masonac3/edf-testbed/LOG.md

# Engineering Log

Append only. Never edit a past entry - if it was wrong, write a new entry
saying so. One entry per working session, including sessions where nothing
worked, because those are the ones worth having later when a result looks
strange.

---

## TEMPLATE - copy this block

```
## YYYY-MM-DD

Config: <ID from CONFIGS.md>
Ambient: <T degC, P hPa, RH %>

Intent:
- what I set out to do

Did:
- what actually happened
- raw files written: data/raw/...

Observed:
- numbers, anomalies, things that looked wrong

Notes / next:
- open questions, what to try next time
```

---

## 2026-09-09

Config: n/a
Ambient: n/a

Intent:
- Set up repo

Did:
- Repo initialised.

Observed:
- n/a

Notes / next:
- Tomorrow I would like to order all my parts and then do some CAD for what my test stand will look like.
- I will use the budgeting document and fill in/correct any prices that may differ from the sheet to real life. I think what is more important than manually correcting the prices is to just have what I actually spent written down. Goodnight 09/09 Mason

## 2026-09-10

Config: n/a
Ambient: n/a

Intent:
- Today I want to purchase wave 1, make sure everything is ready to go and hopefully start CAD if possible.

Did:
- Was sick this morning so lost some work time, main things accomplished today were wave 1 purchases. I also made some changes as the EDF trainer plane I bought needed some different specs and some items I wanted were out of stock. CAD didn't start, talked to Jayden looked into some competitions like DARPA Lift challenge may look into this more on the side however this project will take priority. Something that drew me to DARPA was that unlike this project that has design constraints choosen by myself, competitions are designed with specific goals rather than just to gain more experience. I think that it would be cool to take part and see how far I can get. Below will be some purchases that deviated from the original plan:
- Recievers (RadioMaster ER8 ELRS PWM) 2 -> 1 as it was more than I expected and it won't be needed till march during phase 5 anyways when I begin the actual airframe
- LiPo battery changed from 4000 mAh/XT60 to 3300 mAh/EC5. 4000mAh was out of stock, 3300 will be enough and was the best option in the moment to recieve all parts on time and begin test flights for phase 0. EC5 was the only option here too so EC5 - XT60 convertors were bought too. 
- LiPo battery 3 -> 2, Amazon sold in pairs, not too big of a deal honestly. If I need another I'll just buy it later on, also charger only does 2 at a time anyways so it'll be fine. 

Observed:
- n/a asides from big bucks spent ($974.15)

Notes / next:
- Tomorrow when I'm free I would like to begin the CAD and watch videos to be better informed for the phases coming up. For CAD specifically start the Thrust stand hopefully finish by Saturday if possible as thats when alot of parts come. This will also include how I want the thurst stand to be designed, quick drawing on ipad first then create the cad.

## 2026-09-14

Config: n/a
Ambient: n/a

Intent: 
- Mark down on purchase tracker what arrived in the mail. Some things are still not here, and I'm a little unsure how to proceed (wait till trainer gets here or start something now). For now, I will just mark down on the tracker and ask claude for something to do.

Did:
- Marked down items that were received yesterday and today. Spoke to claude about things to do, want to work on some CAD or study components but dont have much time today.
- 

Observed:
- n/a

Notes / next:
- Today was a small day, I would like to watch more informational videos to get a better understanding of this project. I also want to work on the CAD like I spoke about earlier, as I didn't have much time today.

## 2026-09-24

Config: n/a
Ambient: n/a

Intent:
- Watch PF-1 from LearnNX to study necessary tools for making CAD with variations. Begin test stand CAD. Some more packages arrived so look at everything that has come and verify with purchase tracker.

Did:
- Finished watching the video and organized CAD folder. Created first cad part file for baseplate of test stand. 

Observed:
- YAK130 arrived as well as the Radiomaster controller, but can't find in package room so will call tomorrow morning to find.

Notes / next:
- Get packages. complete more cad.

## 2026-10-03

Config: n/a
Ambient: n/a

Intent:
- IM BACK. Today I will work on test stand cad, some packages also arrived finally so I need to mark it down in the purchase tracker. Also YAK-130, rc controller, reciever, and some batteries came so I'll charge the batteries later and try to test fly tomorrow. 

Did:
- Found Datasheet for TAL220, completed CAD for basestand, however need to do some measurements and planning for the rest of the stand.

Observed:
- numbers, anomalies, things that looked wrong

Notes / next:
- continue working on CAD
