masonac3/edf-testbed/admin/EDF_Project_Phase_Plan.docx

# Chin-Inlet EDF UAV Testbed — Phase Execution Plan

Project objective: Quantify the installed thrust penalty of a chin-mounted S-duct inlet on a 70 mm EDF, reduce it through design iteration, and validate a CFD model against self-generated test data on a flying airframe.

Primary figures of merit: Duct loss coefficient, installed thrust ratio, and DC60 distortion, tied to predicted and measured maximum level airspeed.

Revision A — corrected metric scale. The first version of this plan set inlet pressure recovery thresholds at 0.95 / 0.98, borrowed from turbine engine practice. Those are wrong by more than an order of magnitude for an EDF. See "Why the metrics are scaled this way" below.

## Cross-cutting rules

These apply to every phase. Violating them is how projects lose their data.

Configuration control. Every physical article that goes on the stand gets an ID and a card: N-085-A = nozzle, 85% FSA, first print. Record the ID on every data run. Two identical-looking printed nozzles are not identical, and six months later you will not remember which was which.

Measure what you built, not what you drew. Printed dimensions deviate from CAD by up to a few tenths of a millimeter. Caliper every exit diameter, every throat, and report the measured value. Area scales as diameter squared, so a 0.3 mm error on a 25 mm exit is a 2.4% area error — bigger than the effects you're chasing.

Record ambient conditions every session. Temperature, pressure, humidity. Air density varies ~10% between a cold morning and a hot afternoon, and thrust scales directly with it. Correct all thrust data to standard density (1.225 kg/m³) before comparing across days:

T_corrected = T_measured × (1.225 / ρ_measured)

Uncorrected data taken on different days is not comparable, and this is the single most common way amateur thrust testing produces garbage.

Log entry per session, same day. Date, config IDs, ambient conditions, what you intended, what happened, what broke, raw file names. Append-only.

Test report per phase, within one week. Objective / hardware / procedure / raw data / uncertainty / results / conclusions. The final paper is an assembly of these, not new writing.

## Phase 1 — Thrust stand and uninstalled baseline

Objective: Build a measurement system you trust, and characterize the bare fan with no ducting. Everything downstream is measured relative to this baseline, so if Phase 1 is sloppy the whole project is.

### Hardware

Item | Notes
Load cell, 5 kg | 10 kg if you plan to move to 12S later. Straight beam type.
HX711 breakout | 24-bit ADC, cheap, adequate. Runs at 10 or 80 SPS — use 80.
Arduino Nano or ESP32 | ESP32 if you want wireless logging
Inline watt meter, or INA226 + divider | INA226 logs; a hobby watt meter you read by eye does not
Optical tachometer | Or ESC telemetry if your ESC supports it
Calibration masses | 100 g / 200 g / 500 g / 1 kg, known to ±1%
Thermometer, barometer, hygrometer | Phone barometers are adequate; note the source
Bench PSU (preferred) or fresh 6S pack | See voltage sag note below

### Stand design

Direct axial mount — load cell in line with the thrust axis — is simpler than a pivot arm and avoids lever-ratio error. Mount the fan so the exhaust is clear for at least 5 fan diameters and the inlet is at least 3 diameters from any wall or the floor. Recirculation is invisible and will quietly inflate or deflate your numbers.

The stand must be stiff. A structure that resonates at fan frequency turns your load cell into an accelerometer. If your readings show large oscillation that grows with rpm, that's structural, not aerodynamic.

### Calibration procedure

1. Warm up the electronics 10 minutes before zeroing. Load cells drift thermally.
2. Hang known masses in ascending order, record raw ADC counts at each.
3. Hang them again in descending order. The difference between ascending and descending readings at the same load is hysteresis — record it, it goes in your uncertainty budget.
4. Fit a linear calibration. Report R² and the maximum deviation from linearity.
5. Re-zero and check drift over 10 minutes with no load.

### Test procedure

Throttle sweep, 30% to 100% in 10% steps, 5 seconds stabilized at each point, then descending back down. Record thrust, current, voltage, rpm at each point.

Voltage sag will corrupt this if you let it. A 6S pack drops meaningfully under a 60 A load, so a descending sweep runs at lower voltage than the ascending one and you'll see apparent hysteresis that's really just battery state of charge. Either use a bench supply, or record voltage at every point and plot thrust against actual electrical power rather than throttle percentage.

### Uncertainty budget

Build the table now; you'll reuse it all project. Contributors: load cell nonlinearity, hysteresis, zero drift, ADC quantization, calibration mass tolerance, air density measurement, rpm measurement, voltage/current sensor accuracy. Combine in quadrature for the total. Report every result as value ± uncertainty.

This is the part almost no undergraduate does, and it's the part that makes the rest credible.

### Exit gate

Three complete sweeps on three separate days agree within ±2% at every throttle point after density correction, with a documented uncertainty budget.

### Deliverable

Test Report 01 — calibration curve, thrust / power / rpm vs. throttle, uncertainty budget, repeatability data.

### Common failure modes

Stand resonance corrupting readings · thermal drift from skipping warmup · recirculation from testing too close to a wall · ESC or motor heat soak changing performance partway through a sweep (let it cool between runs).

## Phase 2 — Nozzle exit area trade study

Objective: Quantify the mass flow vs. exhaust velocity tradeoff and pick the exit area that maximizes predicted top speed, not static thrust.

### Preparation

Compute FSA from measured hardware, not the spec sheet:

FSA = (π/4) × (D_fan² − D_hub²)

Print four nozzles at 90%, 85%, 80%, 78% of FSA. Hold everything else constant — same bellmouth inlet, same thrust tube length, same contraction length, same material, same layer height, same interior finish. One variable at a time.

Contraction should be gradual. A sharp area change separates and you'll be measuring your bad geometry rather than the area ratio.

Caliper each exit and record the actual area.

### Test procedure

Identical to Phase 1. Three runs per nozzle, ideally interleaved across days rather than all four nozzles on one day — that way a day-to-day bias doesn't map onto the variable you're studying.

### Analysis

For each nozzle compute:

- Static thrust, density corrected, with error bars
- Thrust per watt
- rpm vs. area ratio (rpm should rise as area shrinks — the fan is unloading aerodynamically; if it doesn't, something is wrong)
- Estimated exhaust velocity: from T = ρ·A_exit·Ve², so Ve = √(T / (ρ·A_exit))
- Predicted Vmax for each, by solving the thrust-drag intersection with an estimated airframe drag area:

ṁ(Ve − V) = ½ρV²·CD0·S

The last one is the point. Expect static thrust to fall as you tighten the nozzle while predicted Vmax rises. That inversion is the whole result, and it's the plot that goes in the paper.

### Exit gate

Four nozzles ranked with error bars, and a selection justified on predicted Vmax with the static thrust penalty stated explicitly.

### Deliverable

Test Report 02 — nozzle trade study.

## Phase 3 — Inlet characterization (core phase)

Objective: Measure total pressure recovery and DC60 distortion for three inlet configurations. This is the phase that produces the resume line.

### Configurations

ID | Description | Role
I-STR | Straight duct, bellmouth inlet | Control — best achievable
I-SD1 | Chin S-duct, baseline | The design under test
I-SD2 | Chin S-duct + boundary layer diverter + flow conditioning | The improvement

I-SD2 conditioning options worth trying: a splitter plate standing the lip off the fuselage by 1.5–2× local boundary layer thickness, vortex generators upstream of the second bend, and increased bend radius if packaging allows.

### The rake

Eight total pressure probes on a single radial arm, indexed circumferentially in 45° increments to map the full fan face. This is far cheaper than 40 fixed probes and removes probe-to-probe bias, at the cost of taking eight times as long.

Place probes at equal-area centroids, not equal radial spacing. For an annular face, divide the annulus into 8 equal-area rings and put a probe at each ring's area centroid. Equal spacing over-weights the hub and will systematically bias your average.

Probes: hypodermic tubing, square-cut, facing directly into the flow. Total pressure probes are forgiving to about ±10° of misalignment and under-read badly past that, so alignment matters more than probe quality.

Keep total rake blockage under 5% of the fan face area. Above that you're measuring a flow field you created.

Sensor selection — this is where the first version of this plan was wrong. An MPXV7002DP is ±2 kPa full scale with roughly 2.5% FS accuracy, which is ±50 Pa of error. The pressure differences you are trying to resolve are 150–400 Pa. That's 12–30% error on your primary measurement, which would swamp the effect.

Use a low-range digital sensor instead. Sensirion SDP31 or SDP810 (±500 Pa, roughly 0.2% of reading, sub-Pascal resolution over I²C) puts your sensor error two orders of magnitude below your signal. Roughly $40–60 each, which is why multiplexing matters: solenoid-multiplex all eight tubes into one good sensor rather than buying eight mediocre ones. That also eliminates sensor-to-sensor calibration bias entirely.

Mount the rake at least 0.5 fan diameters upstream of the blades. Closer and you're in the blade potential field.

### Calculations

Pressure recovery: PR = P̄t2 / Pt0, where P̄t2 is the area-weighted average of your probe readings and Pt0 is ambient total pressure for static testing.

DC60: DC60 = (P̄t2 − P̄t2,worst60) / q2

where P̄t2,worst60 is the lowest average over any contiguous 60° sector, and q2 is dynamic pressure at the fan face. Write your exact definition into the report — DC60 has variants and reviewers will ask which you used.

### The honest limitation

Static ground testing does not reproduce flight inlet conditions. At zero forward speed the inlet runs at very high mass flow ratio, the lip loads up differently, and you get no forebody boundary layer to divert — which is the entire problem the diverter exists to solve. Your static numbers will look better than reality.

Say this plainly in the report. Better: get a session in the UIUC subsonic tunnel and repeat at 20–30 m/s. Even one tunnel run alongside your static data transforms the credibility of this phase, and a reviewer who sees the limitation acknowledged trusts the rest of your work more, not less.

### Exit gate

Three configurations characterized with differences that exceed measurement uncertainty. Target: reduce duct loss coefficient K by ≥0.15 from I-SD1 to I-SD2, equivalently recovering ≥5% of fan pressure rise, or a documented explanation of why not.

### Why the metrics are scaled this way

Work the fan's pressure rise backwards from exhaust velocity:

Δp_fan ≈ ½ρVe² = ½(1.225)(65²) ≈ 2,600 Pa

Against 101,325 Pa ambient, that is a pressure ratio of about 1.026. A turbofan runs 30–40. Everything about ducting an EDF follows from that number.

Duct losses scale with dynamic pressure inside the duct: Δp_loss = K · q_duct. At 45 m/s duct velocity, q_duct ≈ 1,240 Pa, so a single bend at K = 0.3 costs ~370 Pa — 14% of everything the fan produces.

This is why turbine-engine recovery figures are the wrong instrument. A PR of 0.95 means losing 5,000 Pa, roughly double the fan's entire output; the airplane would not move. Real EDF ducts need PR above 0.995, where all the information lives in the third decimal place and the metric becomes useless for tracking progress.

Use these instead:

Metric | Definition | Threshold | Objective
Duct loss coefficient | K = Δp_loss / q_duct | ≤ 0.35 | ≤ 0.15
Fraction of fan rise lost | Δp_loss / Δp_fan | ≤ 15% | ≤ 7%
Installed thrust ratio | T_installed / T_bare | ≥ 88% | ≥ 93%
Pressure recovery (reference only) | PR = P̄t2 / Pt0 | ≥ 0.995 | ≥ 0.998

Installed thrust ratio is the one to lead with in conversation — it is the easiest to measure, the hardest to argue with, and the easiest to explain in an interview. DC60 is unchanged; distortion is genuinely dimensionless and the standard definition transfers fine.

### Deliverable

Test Report 03 — inlet characterization. The core artifact.

### Common failure modes

Probe misalignment · tubing lag (long thin tubes low-pass filter your signal; keep runs short and equal length) · rake blockage · leaks at tube fittings (leak-check every line before every session).

## Phase 4 — CFD correlation

Objective: Predict PR and DC60 in Fluent, compare against Phase 3 measurements, and honestly characterize the disagreement.

### Setup

Do not model the rotating fan. Terminate the domain at the fan face and apply a mass flow outlet set to your measured ṁ. Sliding mesh or MRF for the rotor is a semester-long project by itself and adds nothing to an inlet study.

Domain: large hemispherical plenum upstream (at least 10 duct diameters) so the inlet draws from quiescent air, then the duct geometry as printed.

Mesh: prism layers on all duct walls. Either resolve the boundary layer with y+ < 1, or use wall functions with y+ between 30 and 300 — pick one and stay inside it. Report the y+ distribution, not just the target.

Turbulence model: SST k-ω. It handles adverse pressure gradients and separation in the S-bend better than k-ε, and separation is exactly what you're trying to capture.

### Grid independence study

Three mesh levels, roughly doubling cell count each time. Plot PR against cell count and show it converging. This is mandatory for credibility and routinely skipped — including it puts you ahead of most student CFD work immediately.

### Correlation

Compare predicted vs. measured PR and DC60. Report the discrepancy as a percentage and hypothesize causes: unmodeled surface roughness from layer lines, as-printed geometry deviation from CAD, rake blockage absent from the model, oversimplified fan face boundary condition.

A report that says "predicted 0.971, measured 0.958, a 1.3% discrepancy attributed primarily to unmodeled print surface roughness" is worth far more than one claiming perfect agreement. Nobody believes perfect agreement.

### Exit gate

Grid-independent solution for all three configurations, correlation within ±8% (threshold) or ±4% (objective) on PR, with discrepancies attributed.

### Deliverable

CFD Validation Report.

## Phase 5 — Airframe integration and flight test

Objective: Fly the airframe with the winning duct and nozzle, measure actual Vmax, and compare against the thrust-drag prediction from Phases 2 and 3.

### Design targets

- Static margin 8–12% MAC for first flight. Conservative on purpose; you can move CG aft later once it's flying.
- Horizontal tail volume coefficient Vh ≈ 0.5
- Vertical tail volume coefficient Vv ≈ 0.04
- Printed shell (LW-PLA), carbon tube spar carrying bending, PETG or ASA anywhere near the motor
- Plywood or CF hardpoint at the nose gear mount
- Nose gear aft of the inlet lip, or a mudguard on the strut

### Instrumentation

Pitot-static airspeed, current, voltage, rpm (ESC telemetry), 6-axis IMU, GPS, barometric altitude. IMU at ≥50 Hz, everything else at 10 Hz.

Calibrate the pitot before you trust it. Simplest method: tape it to a car roof on a still day and drive at known speeds. Uncalibrated pitot data is the most common reason flight test numbers don't match predictions.

### Pre-flight ground tests

Range check · control surface throw and direction verification · CG measurement against the design value · installed static thrust on the stand (compare to Phase 3 prediction) · taxi tests at increasing speed.

### Flight test cards

One objective per card, defined conditions, specific data product. Fly them in this order — this is envelope expansion, not a checklist to rush.

Card | Objective | Conditions | Data
FT-1 | Trim and handling | 50–60% throttle, altitude | Subjective; does it fly hands-off
FT-2 | Level speed runs | 50/60/70/80/90/100%, ≥5 s stabilized, reciprocal headings | Airspeed, current, voltage, rpm
FT-3 | Timed acceleration | Full throttle from marked speed | Airspeed vs. time
FT-4 | Sawtooth climbs | Fixed throttle, fixed airspeed, timed altitude gain | Climb rate for Ps calculation
FT-5 | Stall approach | At altitude, decelerating | Vstall for speed range ratio

Fly reciprocal headings on every speed run and average them. Wind otherwise biases your ground speed by the full wind velocity, and a 10 mph wind on a 130 mph airplane is an 8% error in one direction.

### Exit gate

Measured Vmax within 15% of the thrust-drag intersection predicted in Phase 2, or a documented explanation of the gap (usually drag area estimated too optimistically).

### Deliverable

Flight Test Report, including the predicted vs. measured thrust and drag curve overlay. That single plot closes the loop from analysis through ground test to flight test, and it's the figure that carries the paper.

## Phase 6 — Tail configuration study

Objective: Quantify the lateral-directional stability cost of canted twin verticals versus a single centerline fin.

### Configurations

Single centerline fin of area S_v, versus twin fins canted at angle θ, sized so 2 × S_twin × cos(θ) = S_v. That sizing is the point — it tests whether the cosine loss is the whole story or whether interference effects make it worse.

Make both tails swappable on the same airframe. Same CG, same weight (ballast to match), same test day.

### Procedure

At trim speed and altitude, input a sharp rudder doublet, then release to neutral and let the Dutch roll mode decay. Log yaw rate and roll rate through the IMU.

Extract from the yaw rate trace:

- Frequency from peak-to-peak spacing
- Damping ratio by the logarithmic decrement method on successive peak amplitudes

Repeat at least five times per configuration. Dutch roll extraction from a single noisy trace is unreliable; the repeats are what give you error bars.

### Exit gate

Frequency and damping ratio reported for both configurations with uncertainty, plus discussion of roll-yaw coupling differences.

### Deliverable

Test Report 04 — tail configuration study. This one is a clean A/B with measured stability derivatives, which is unusual in student work and reads very well.

## Schedule

Period | Phases
Fall 2026 | Phase 0 (proficiency), Phase 1, Phase 2
Winter break | Phase 3 rake fabrication, airframe CAD
Spring 2027 | Phase 3, Phase 4, Phase 5
Summer / Fall 2027 | Phase 6, paper writeup, AIAA Region III submission

AIAA Region III Student Conference papers are typically due in late winter for a spring conference — check the current deadline early, because it may force Phase 5 earlier than this schedule shows.

## Procurement

All hardware selection, pricing, and purchase sequencing live in the companion document, EDF_Project_Purchasing.md. The baseline build is a Schübeler DS-30-AXI HDS 70 mm fan with a 6S propulsion system and a deferred 12S upgrade path.

## Top risks

Risk | Mitigation
Airframe destroyed early, halting flight test | Phase 0 proficiency gate; print a second fuselage during Phase 3
Measurement uncertainty exceeds the effect size | Phase 1 gate exists precisely to catch this before it wastes Phase 3
Static-only inlet data lacks credibility | Pursue tunnel access early; acknowledge the limitation regardless
Schedule slips past the conference deadline | Reports are written per phase, so a partial paper is still submittable
Fluent license or access falls through | SU2 and OpenFOAM are free alternatives; identify a backup before Phase 4
Instrument resolution too coarse for the effect | Group A sensor selection addresses this; verify against a known reference before Phase 3
