masonac3/edf-testbed/admin/EDF_Project_Purchasing.docx

# Chin-Inlet EDF UAV Testbed — Purchasing and Cost Plan

Baseline configuration: Schübeler DS-30-AXI HDS 70 mm fan, 6S propulsion, deferred 12S upgrade path.

Prices are US street estimates and drift. Verify before ordering.

## Summary

| Estimate
Core build (Groups A–E) | $2,656
Contingency at 15% | $400
Core total | $3,056
Optional 12S upgrade (Group F) | $550
With 12S upgrade | $3,606

Deduct if already owned: transmitter $220, balance charger $90, bench power supply $120.

## Group A — Test stand and instrumentation

Needed for Phases 1–3.

Item | Spec | Qty | Unit | Total
Load cell | 10 kg straight beam | 1 | $12 | $12
HX711 ADC breakout | 24-bit, run at 80 SPS | 1 | $6 | $6
Arduino Nano | Stand + airborne spare | 2 | $12 | $24
Sensirion SDP810-500Pa | ±500 Pa differential, I²C | 1 | $55 | $55
Pneumatic solenoids | 3-way, 12 V, for rake multiplexing | 8 | $9 | $72
MOSFET driver board | ULN2803 or logic-level discretes | 1 | $12 | $12
Silicone tubing | 2 mm ID, 5 m, cut to equal lengths | 1 | $10 | $10
Hypodermic tubing | 19 ga, 1 m, rake probes | 1 | $15 | $15
INA226 sensor | Current + voltage logging | 2 | $9 | $18
Optical tachometer | Omit if ESC provides RPM telemetry | 1 | $22 | $22
Calibration mass set | 100 g / 200 g / 500 g / 1 kg, ±1% | 1 | $30 | $30
Barometer + thermo-hygrometer | For density correction | 1 | $22 | $22
Bench power supply | 24 V, 30 A minimum | 1 | $120 | $120
| | | Subtotal | $418

Use one SDP810 multiplexed across all eight rake tubes rather than eight separate sensors — cheaper and removes sensor-to-sensor bias.

## Group B — Propulsion

Needed for Phases 1–2.

Item | Spec | Qty | Unit | Total
Schübeler DS-30-AXI HDS | 70 mm fan unit, HDS rotor, alloy stator | 1 | $230 | $230
Schübeler DSM inrunner | 6S rated — confirm Kv with vendor for the DS-30 | 1 | $130 | $130
Hobbywing Platinum 120 A V4 | 6S ESC, mount in duct airflow | 1 | $110 | $110
LiPo pack | 6S 3300 mAh 70C | 3 | $70 | $210
Balance charger | 200 W minimum | 1 | $90 | $90
XT90 connector set | Main power, battery and ESC ends | 1 | $18 | $18
Silicone wire | 10 AWG, 3 m, red and black | 1 | $16 | $16
Low-ESR capacitors | 35 V, on ESC leads | 4 | $3 | $12
| | | Subtotal | $816

Buy the fan housing once. Schübeler motor options span 6S–12S in the same housing, so the 12S move later is a motor swap only.

## Group C — Airframe electronics

Needed for Phase 5.

Item | Spec | Qty | Unit | Total
Matek F405-WING | ArduPlane, manual passthrough as logger | 1 | $60 | $60
DLVR-L10D + pitot probe | Differential airspeed, low drift | 1 | $50 | $50
GPS / compass module | Ground speed for wind correction | 1 | $32 | $32
KST X10 servos | Digital, metal gear, thin form factor | 5 | $40 | $200
JP Hobby retract set | 70 mm class, alloy oleo struts, 3 units | 1 | $150 | $150
Retract sequencer | If not integrated with the retract set | 1 | $30 | $30
Switching BEC | 8 A, separate from ESC BEC | 1 | $22 | $22
ELRS receiver | Full range, one spare | 2 | $30 | $60
RadioMaster TX16S MKII | ELRS internal module | 1 | $220 | $220
| | | Subtotal | $824

## Group D — Materials and consumables

Needed from Phase 2 onward.

Item | Spec | Est.
LW-PLA filament | 3 kg, airframe shells and wing skins | $95
PETG or ASA | 1 kg, duct and motor-adjacent parts | $28
PA-CF filament | 0.5 kg, gear mounts and hardpoints | $55
Carbon tube spars | Pultruded, assorted diameters | $60
Epoxy, filler primer, sandpaper | Duct interior finish | $55
Plywood, hardware, hinges, pushrods | | $45
| Subtotal | $338

## Group E — Phase 0 proficiency trainer

Needed first.

Item | Spec | Est.
Foam EDF jet, PNP | 64–70 mm, buy used where possible | $230
Spares and foam-safe CA | | $30
| Subtotal | $260

## Group F — 12S upgrade (deferred)

Order only after Phase 5 flight data confirms the airframe is sound.

Item | Spec | Est.
Schübeler DSM inrunner | 12S rated, same housing | $145
Castle Phoenix Edge HV 120 | HV-rated ESC | $170
LiPo packs | 3 × 6S 3300 mAh, series pairs | $210
AS150 anti-spark connector set | 12S main power | $25
| Subtotal | $550

## Purchase sequence

Wave | When | Contents | Spend | Running
1 | Now | Group E trainer, Group A stand electronics | $678 | $678
2 | Week 3 | Group B propulsion | $816 | $1,494
3 | Week 6 | Group A rake sensors and solenoids (if split out) | — | $1,494
4 | Winter break | Group D materials | $338 | $1,832
5 | Spring, pre-Phase 5 | Group C airframe electronics | $824 | $2,656
6 | After Phase 5 | Group F 12S upgrade | $550 | $3,206

Order the Schübeler unit early in Wave 2 — European stock and shipping to the US can run several weeks, and Phase 2 cannot start without it.

## Funding

Apply before spending. The phase plan document is written to serve directly as the technical attachment.

Source | Typical range | Notes
AIAA student branch project funding | $200–800 | Branch officers; ask about the current cycle
Department undergraduate research award | $500–2,000 | Usually requires a faculty sponsor
Aerospace department project support | Varies | Ask about tunnel time as in-kind alongside cash
Campus makerspace filament and shop credit | $50–200 | Covers most of Group D

Tunnel access is worth more to this project than an equivalent dollar amount — it addresses the largest credibility gap in Phase 3.

## Running purchase log

Fill in as you order. Keep receipts against the funding sources.

Date | Item | Vendor | Qty | Actual cost | Funding source | Received
