masonac3/edf-testbed/admin/EDF_Purchasing_Tracker.xlsx

Sheet: README
Chin-Inlet EDF UAV Testbed - Purchasing Tracker
HOW TO USE
Fill in only the shaded yellow cells: Unit Price, Vendor, Order Date, Received.
Line Total, and everything on the By Group tab, calculates itself.
Set the Buy column to Yes once an item is ordered. The row turns green and
the totals at the bottom of the Items tab update.
Prices are deliberately left blank - fill in what you actually pay, including
shipping and tax, so the totals reflect real spend rather than estimates.
GROUPS
A - Test stand and instrumentation. Needed for Phase 1.
A2 - Pressure rake hardware. DEFERRED to Phase 3, months out.
B - Propulsion. Needed for Phases 1-2.
C - Airframe electronics. Needed for Phase 5.
D - Materials and consumables. Phase 2 onward.
E - Phase 0 proficiency trainer. Needed FIRST.
F - 12S upgrade. Only after Phase 5 flight data.
WAVE 1 - buy now
Rows with a bold item name and a green Group cell are Wave 1.
Filter the Group column to A - Test stand and E - Trainer to see them.
Order the trainer today. Phase 0 needs 20 flights and decent weather, and
Illinois winter is the real schedule constraint - not part lead times.
Order the Schubeler fan early in Wave 2. European shipping runs several
weeks and Phase 2 cannot start without it.
CHECK BEFORE BUYING
Soldering iron: borrow before buying.
Solder, heat shrink, hookup wire, breadboard: try the ECE Supply Center or
the JIS storeroom in the Sidney Lu basement before ordering online.
Optical tachometer: check whether the Hobbywing Platinum V4 already gives
RPM telemetry. If it does, skip it.
Bench power supply: try batteries with watt logging first. If Phase 1 hits
+/-2% repeatability without it, you never needed it.

Sheet: Items
 | Group | Item | Specifics | Qty | Unit Price | Line Total | Vendor | Order Date | Received | Notes
Yes | A - Test stand | Load cell | 10 kg straight bar, 4-wire full bridge | 1 | $24.33 | $24.33 | SparkFun | 2026-09-10 | 2026-09-28 | Usually sold bundled with HX711
Yes | A - Test stand | HX711 breakout | 24-bit ADC for load cell, run at 80 SPS | 2 | $3.50 | $6.99 | Amazon | 2026-09-10 | 2026-09-13 | Often included in the load cell kit
Yes | A - Test stand | Arduino Nano | ATmega328P, USB-C or mini-B; clone is fine | 3 | $5.33 | $15.99 | Amazon | 2026-09-10 | 2026-09-13 | Second board is a spare
No | A - Test stand | INA226 module | I2C current + voltage sensor, w/ shunt | 2 |  |  |  |  |  | Logs electrical power
Yes | A - Test stand | Digital multimeter | Klein MM420 | 1 | $64.82 | $64.82 | Amazon | 2026-09-10 | 2026-09-13 | Own this one, don't borrow
Yes | A - Test stand | Calibration mass set | 100 g / 200 g / 500 g / 1 kg, +/-1% or better | 1 | $21.98 | $21.98 | Amazon | 2026-09-10 | 2026-09-13 | Accuracy floor for all thrust data
Yes | A - Test stand | Thermo-hygrometer | Digital, temperature + relative humidity, GOVEE H5075 | 1 | $12.99 | $12.99 | Amazon | 2026-09-10 | 2026-09-13 | Sits at the stand, not a phone app
No | A - Test stand | C-clamps | 4-6 inch throat | 2 |  |  |  |  |  | Clamps baseplate to table
No | A - Test stand | Solder | Rosin core, 0.8 mm, 60/40 or lead-free | 1 |  |  |  |  |  | Try ECE Supply Center first
No | A - Test stand | Heat shrink assortment | 1-6 mm diameters | 1 |  |  |  |  |  | Try ECE Supply Center first
No | A - Test stand | Hookup wire | 22 AWG stranded, multiple colors | 1 |  |  |  |  |  | Try ECE Supply Center first
No | A - Test stand | Breadboard + jumper kit | 830-point board, M-M and M-F jumpers | 1 |  |  |  |  |  | Prototype before soldering
No | A - Test stand | Plywood | 3/4 inch, approx 400 x 250 mm offcut | 1 |  |  |  |  |  | Baseplate; stiffness matters
No | A - Test stand | Screws / standoffs / spacers | M3 and M4 assortment, nylon + steel | 1 |  |  |  |  |  | Spacers create the load cell air gap
No | A - Test stand | Soldering iron + station | Temperature controlled, 60W | 1 |  |  |  |  |  | BORROW FIRST - only buy if shop hours block you
No | A2 - Rake (Phase 3) | Sensirion SDP810-500Pa | +/-500 Pa differential, I2C, sub-Pa resolution | 1 |  |  |  |  |  | NOT MPXV7002DP - too coarse for 150-400 Pa signals
No | A2 - Rake (Phase 3) | Pneumatic solenoid valve | 3-way, 12 V, small port | 8 |  |  |  |  |  | Multiplexes 8 tubes into 1 sensor
No | A2 - Rake (Phase 3) | MOSFET driver board | ULN2803 array or logic-level discretes | 1 |  |  |  |  |  | Arduino drives the solenoids
No | A2 - Rake (Phase 3) | Silicone tubing | 2 mm ID, 5 m | 1 |  |  |  |  |  | Cut all runs to EQUAL length
No | A2 - Rake (Phase 3) | Hypodermic tubing | 19 gauge, 1 m, square-cut ends | 1 |  |  |  |  |  | Rake probe tips
No | A2 - Rake (Phase 3) | Optical tachometer | Non-contact, to 99,999 rpm | 1 |  |  |  |  |  | SKIP if Hobbywing V4 gives RPM telemetry
No | A2 - Rake (Phase 3) | Bench power supply | 24 V, 30 A adjustable | 1 |  |  |  |  |  | DEFERRED - try batteries + watt logging first
No | B - Propulsion | Schubeler DS-30-AXI HDS | 70 mm fan unit, HDS rotor, alloy stator | 1 |  |  |  |  |  | Order early - EU shipping is the long pole
No | B - Propulsion | Schubeler DSM inrunner motor | 6S rated - confirm Kv with vendor for DS-30 | 1 |  |  |  |  |  | Same housing takes a 12S motor later
No | B - Propulsion | Hobbywing Platinum 120A V4 | 6S ESC, 120 A continuous | 1 |  |  |  |  |  | Mount in duct airflow
Yes | B - Propulsion | LiPo pack | 6S 22.2V 3300mAh, EC5 | 2 | $61.20 | $122.40 | Amazon | 2026-09-10 | 2026-09-14 | Two in series = 12S later
Yes | B - Propulsion | ISDT LiPo battery Charger MK2 | 2x200W, 6s | 1 | $96.00 | $96.00 | Amazon | 2026-09-10 | 2026-09-13 | 2C charging keeps test days moving
No | B - Propulsion | EC5 connector set | Male + female pairs, main power | 1 |  |  |  |  |  | XT90 rated 90 A
No | B - Propulsion | Silicone wire | 10 AWG, 3 m, red and black | 1 |  |  |  |  |  | Sized for 100 A continuous
No | B - Propulsion | Low-ESR capacitors | 35 V, 470-1000 uF, on ESC leads | 4 |  |  |  |  |  | Absorbs switching spikes from long leads
No | C - Airframe | Matek F405-WING | ArduPlane capable FC, onboard flash logging | 1 |  |  |  |  |  | Used in manual passthrough as a logger
No | C - Airframe | DLVR-L10D airspeed sensor | Differential, low thermal drift, + pitot probe | 1 |  |  |  |  |  | Preferred over MS4525DO
No | C - Airframe | GPS / compass module | M8N or newer | 1 |  |  |  |  |  | Ground speed for wind correction
No | C - Airframe | KST X10 servo | Digital, metal gear, thin wing form factor | 5 |  |  |  |  |  | MKS equivalent also fine
No | C - Airframe | JP Hobby retract set | 70 mm class, 3 units, alloy oleo struts | 1 |  |  |  |  |  | Not nylon struts
No | C - Airframe | Retract sequencer | Electronic, 3 channel | 1 |  |  |  |  |  | Skip if integrated in retract set
No | C - Airframe | Switching BEC | 8 A, 5-6 V output | 1 |  |  |  |  |  | Separate from ESC linear BEC
Yes | C - Airframe | RadioMaster ELRS ER8 reciever | 2.4 GHz 8 ch ELRS PWM | 1 | $49.99 | $49.99 | Amazon | 2026-09-10 | 2026-09-13 | One spare - lost link at speed is total loss
Yes | C - Airframe | RadioMaster TX16S MKII | ELRS internal module, mode 2, w/ 5000 mAh battery | 1 | $271.99 | $271.99 | Amazon | 2026-09-10 | 2026-09-30 | Skip if you already own a transmitter
No | D - Materials | LW-PLA filament | Foaming lightweight PLA, 3 kg | 1 |  |  |  |  |  | Airframe shells and wing skins
No | D - Materials | PETG or ASA filament | 1 kg | 1 |  |  |  |  |  | Duct, nozzles, thrust tube, motor-adjacent
No | D - Materials | PA-CF filament | Carbon-filled nylon, 0.5 kg | 1 |  |  |  |  |  | Gear mounts and hardpoints
No | D - Materials | Carbon tube spars | Pultruded, assorted diameters | 1 |  |  |  |  |  | Carries wing bending, not printed structure
No | D - Materials | Epoxy + filler primer + sandpaper | Laminating epoxy, 400-1000 grit | 1 |  |  |  |  |  | Duct interior finish converts to thrust
No | D - Materials | Plywood / hardware / hinges / pushrods | Airframe misc | 1
Yes | E - Trainer | Freewing Yak-130 Trainer RC plane | 70mm PNP | 1 | $276.68 | $276.68 | Motion RC | 2026-09-10 | 2026-09-28 | ORDER FIRST - weather is the schedule driver
No | E- Trainer | Foam-safe CA | Odorless CA, activator, spare canopy/gear | 1
No | E - Trainer | 5 min epoxy |  | 1 |  |  |  |  |  | It will get repaired
Yes | E - Trainer | XT60 - EC5 adapter | 2 pairs xt60-ec5 and 2 pairs ec5-xt60 | 1 | $9.99 | $9.99 | Amazon | 2026-09-10 | 2026-09-13
No | F - 12S upgrade | Schubeler DSM inrunner motor | 12S rated, fits same DS-30 housing | 1 |  |  |  |  |  | Only after Phase 5 confirms airframe
No | F - 12S upgrade | Castle Phoenix Edge HV 120 | HV-rated ESC, 12S capable | 1 |  |  |  |  |  | 6S ESC on 12S destroys it instantly
No | F - 12S upgrade | LiPo pack | 6S 3300 mAh 70C, series pairs | 3 |  |  |  |  |  | Pairs with existing packs for 12S
No | F - 12S upgrade | AS150 anti-spark connector set | 12S main power | 1 |  |  |  |  |  | Anti-spark required at 12S inrush
 |  | TOTALS
 |  | Items purchased | 12
 |  | Items remaining | 41
 |  | Spent so far | $974.15
 |  | Still to buy (priced) | $0.00
 |  | Grand total (priced) | $974.15
 |  | Rows still unpriced | 41

Sheet: By Group
Group | Items | Purchased | Group Total | Spent
A - Test stand | 15 | 6 | $147.10 | $147.10
A2 - Rake (Phase 3) | 7 | 0 | $0.00 | $0.00
B - Propulsion | 8 | 2 | $218.40 | $218.40
C - Airframe | 9 | 2 | $321.98 | $321.98
D - Materials | 6 | 0 | $0.00 | $0.00
E - Trainer | 3 | 2 | $286.67 | $286.67
F - 12S upgrade | 4 | 0 | $0.00 | $0.00
TOTAL | 52 | 12 | $974.15 | $974.15
