masonac3/edf-testbed/(list of files, cad)

Other CAD files:
cad/stand/Baseplate.prt
