masonac3/edf-testbed/(commit log)

2026-09-10 Initial scaffold: thrust stand firmware, analysis scripts, log and config register
    [EXAMPLE_cal_sweep.csv, EXAMPLE_run.csv, EXAMPLE_run_corrected.csv]
2026-09-10 add purchasing planner, created admin folder and moved phase and purchase plans into admin
    [EDF_Purchasing_Tracker.xlsx]
2026-09-11 Wave 1 ordered, tracker updated with actuals
    Ordered TAL220, HX711, Nano 3-pack, cal masses, TX16S, ER8, Zeee 3300 EC5 packs, EC5-XT60 adapters, ISDT D2 MK2, Yak-130. Changed LiPo spec 4000/XT60 to 3300/EC5, qty 3 to 2. Group B connector XT90 to EC5. Added adapter row to Group E. Receivers cut from 2 to 1.
    [EDF_Purchasing_Tracker.xlsx]
2026-09-15 Added DECISIONS, and updated LOG and purchase tracker
    [EDF_Purchasing_Tracker.xlsx]
2026-09-26 CAD, organization, and decisions
    [Baseplate.prt]
2026-10-05 CAD + updates
    [Baseplate.prt, EDF_Purchasing_Tracker.xlsx]
